MattWis/MADVLSI-Final/README.md

MADVLSI-Final
=============

An IC to limit current when hooked up to an external power FET
