MattWis/MADVLSI-Final/Report_WDR/Schematic_DAC.pdf

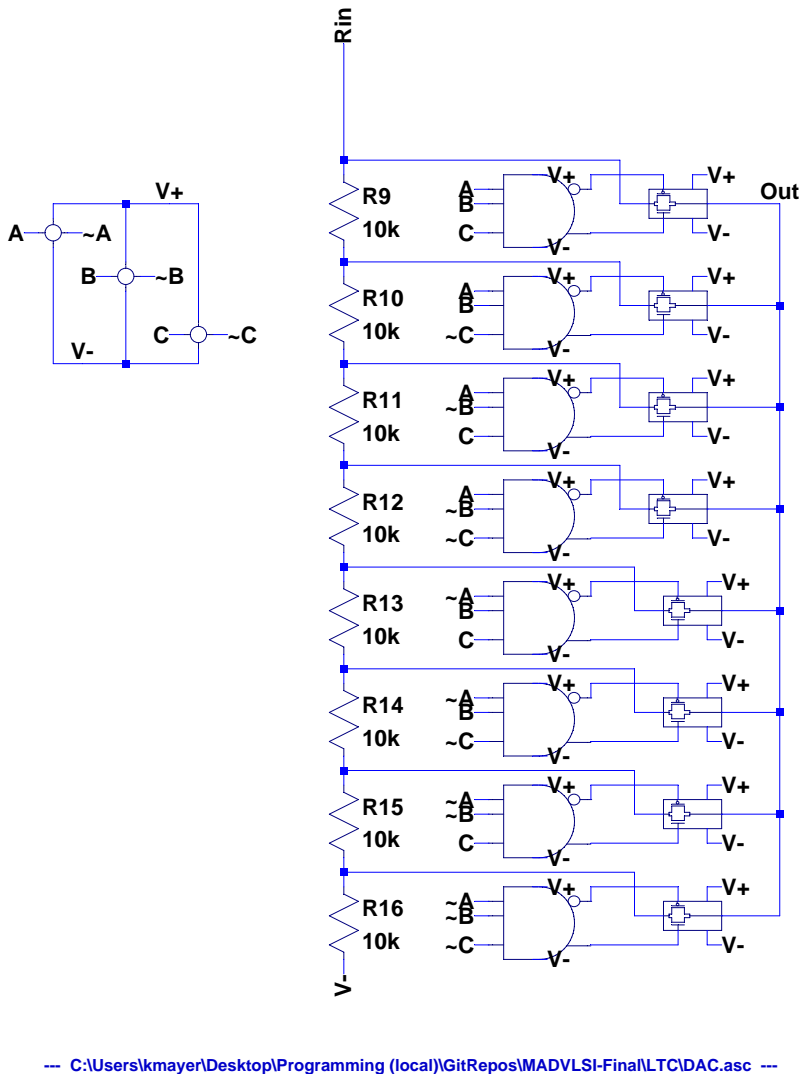
[picture p6: page 1]

--- C:\Users\kmayer\Desktop\Programming (local)\GitRepos\MADVLSI-Final\LTC\DAC.asc ---
