MattWis/MADVLSI-Final/Report_WDR/Schematic_Full_System.pdf

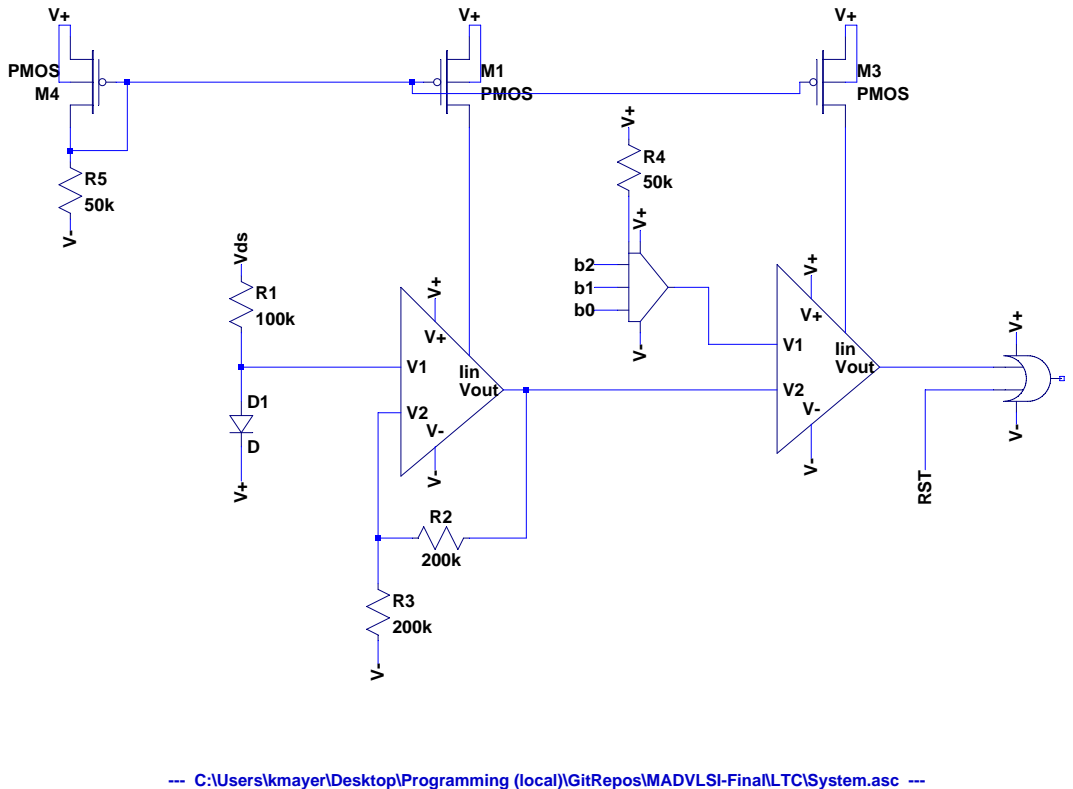
[picture p7: page 1]
Vout; Iin; M1 PMOS; M3 PMOS; PMOS; Vds; RST

--- C:\Users\kmayer\Desktop\Programming (local)\GitRepos\MADVLSI-Final\LTC\System.asc ---
