MattWis/MADVLSI-Final/Report_WDR/Schematic_w_breakpoints.pdf

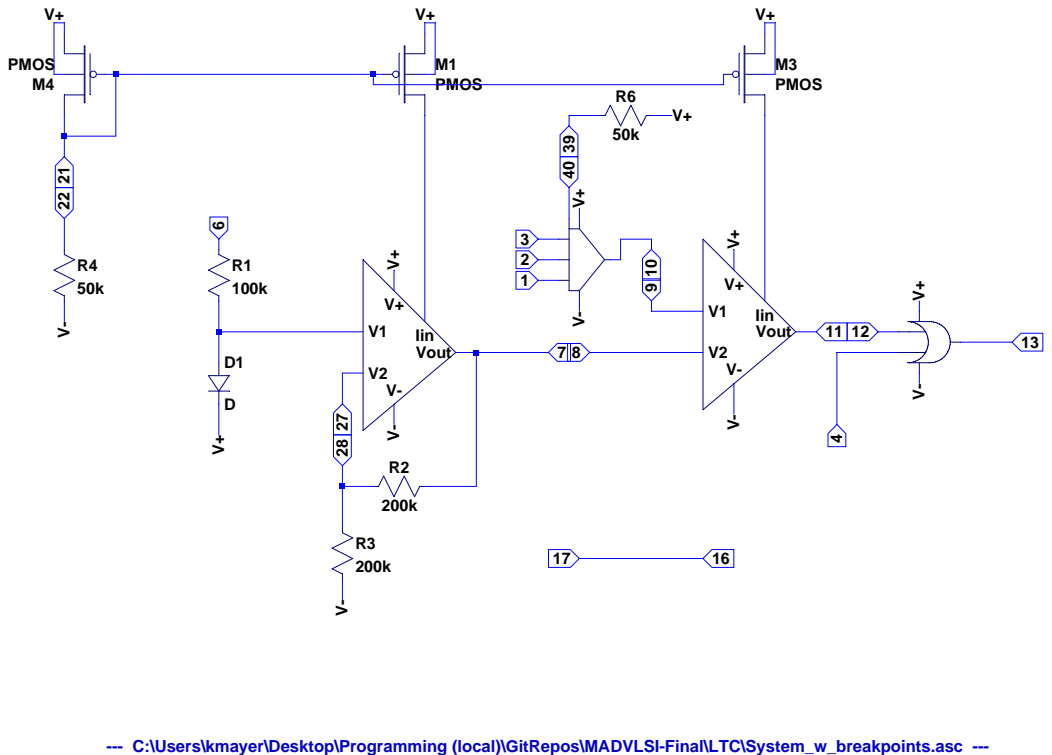
[picture p8: page 1]
Vout; Iin; M1 PMOS; PMOS

--- C:\Users\kmayer\Desktop\Programming (local)\GitRepos\MADVLSI-Final\LTC\System_w_breakpoints.asc ---
