MattWis/MADVLSI-Final/LTC/System_w_breakpoints.asc

D1: diode
M1: pmos4; l=1.8um w=36um
M3: pmos4; l=1.8um w=36um
M4: pmos4; l=1.8um w=36um
R1: res; 100k
R2: res; 200k
R3: res; 200k
R4: res; 50k
R6: res; 50k
X1: DAC
X2: Opamp
X3: Opamp
X5: 2-OR
Named nets: 1, 2, 3, V+, V-, 6, 4, 7, 8, 17, 16, 13, 39, 22, 12, 11, 27, 28, 40, 21, 10, 9
