MattWis/MADVLSI-Final/LTC/2-OR.asc

M1: nmos4; l=0.6um w=1.8um
M2: nmos4; l=0.6um w=1.8um
M3: pmos4; l=0.6um w=1.8um
M4: pmos4; l=0.6um w=1.8um
M5: pmos4; l=0.6um w=3.6um
M6: nmos4; l=0.6um w=1.8um
M7: nmos4; l=0.6um w=18um
M8: nmos4; l=0.6um w=180um
M9: pmos4; l=0.6um w=36um
M10: pmos4; l=0.6um w=360um
Named nets: V-, A, V+, B, Z
