MattWis/MADVLSI-Final/LTC/System.asc

D1: diode
D2: diode
I3: current; PULSE(0 10 1ms 10ms 1ms 0ms 11ms 2)
M1: pmos4; l=1.8um w=36um
M2: nmos; FDS2734
M3: pmos4; l=1.8um w=36um
M4: pmos4; l=1.8um w=36um
R1: res; 100k
R2: res; 200k
R3: res; 200k
R4: res; 50k
R5: res; 50k
V1: voltage; 5
V2: voltage; PULSE(5 0 1ms 100ns 100ns 11ms 20ms 1)
V3: voltage; 0
V4: voltage; 0
V5: voltage; 5
X1: DAC
X2: Opamp
X3: Opamp
X5: 2-OR
Named nets: b0, b1, b2, V+, V-, Vds, 0, RST
.lib engr3426.sub
.tran 30ms
