MattWis/MADVLSI-Final/LTC/DAC.asc

R9: res; 10k
R10: res; 10k
R11: res; 10k
R12: res; 10k
R13: res; 10k
R14: res; 10k
R15: res; 10k
R16: res; 10k
X9: Inverter
X10: Inverter
X11: Inverter
X12: PassGate
X13: PassGate
X14: PassGate
X15: PassGate
X16: PassGate
X17: PassGate
X18: PassGate
X19: PassGate
X20: 3-N-AND
X21: 3-N-AND
X22: 3-N-AND
X23: 3-N-AND
X24: 3-N-AND
X25: 3-N-AND
X26: 3-N-AND
X27: 3-N-AND
Named nets: V-, Rin, A, ~A, B, ~B, C, ~C, V+, Out
