MattWis/MADVLSI-Final/LTC/Bias.asc

M1: nmos4; l=1.8um w=36um
M2: nmos4; l=1.8um w=36um
M3: nmos4; l=1.8um w=36um
M4: nmos4; l=1.8um w=36um
M5: nmos4; l=1.8um w=36um
M6: nmos4; l=1.8um w=36um
M7: nmos4; l=1.8um w=1.8um
M8: pmos4; l=1.8um w=36um
M9: pmos4; l=1.8um w=36um
M10: pmos4; l=1.8um w=1.8um
M11: pmos4; l=1.8um w=36um
M12: pmos4; l=1.8um w=36um
M13: pmos4; l=1.8um w=36um
Named nets: V+, V-, Vcn, Vcp, Vbn, Vbp, Iin, Iip
1/20
1/20
.tran 1ms
