MattWis/MADVLSI-Final/LTC/FCDAmp.asc

M1: pmos4; l=1.8um w=36um
M2: pmos4; l=1.8um w=36um
M3: pmos4; l=1.8um w=36um
M4: pmos4; l=1.8um w=36um
M5: pmos4; l=1.8um w=36um
M6: pmos4; l=1.8um w=36um
M7: pmos4; l=1.8um w=36um
M8: nmos4; l=1.8um w=36um
M9: nmos4; l=1.8um w=36um
M10: nmos4; l=1.8um w=36um
M11: nmos4; l=1.8um w=36um
Named nets: V+, V-, Vout, V1, V2, Vbp, Vcp, Vcn, Vbn
