MattWis/MADVLSI-Final/LTC/Opamp.asc

X1: Bias
X2: FCDAmp
Named nets: V+, V1, V2, Iin, Vbn, Vcn, Vcp, Vbp, Vout, V-
