MattWis/MADVLSI-Final/LTC/3-N-AND.asc

M1: nmos4; l=0.6um w=1.8um
M2: nmos4; l=0.6um w=1.8um
M3: nmos4; l=0.6um w=1.8um
M4: pmos4; l=0.6um w=1.8um
M5: pmos4; l=0.6um w=1.8um
M6: pmos4; l=0.6um w=1.8um
M7: pmos4; l=0.6um w=1.8um
M8: nmos4; l=0.6um w=1.8um
Named nets: A, B, C, V+, V-, ~Z, Z
.lib engr3426.sub
