MattWis/MADVLSI-Final/LTC/PassGate.asc

M1: nmos4; l=0.6um w=1.8um
M2: pmos4; l=0.6um w=1.8um
Named nets: V-, V+, In, Out, A, ~A
