MattWis/MADVLSI-Final/(commit log)

2014-11-13 Schematics for 3 bit DAC with full pass-gates
2014-11-15 Pulled top resistor out of DAC, removed simulation sources
2014-11-18 Add external resistor to DAC, simulate with external FET
2014-11-20 Added OR gate, reset pin
2014-12-01 Use a resistor as a current source, mirror to op-amp bias
2014-12-04 High current output from OR gate
2014-12-16 Initial full-chip layout. Opamps properly connected, start of bias currents
2014-12-17 added all magic files for DAC. both the resistor portion and the rest of it have matching netlists. For some reason the full dac doesn't, but the comp.out says that everything matches up.
2014-12-17 Added 'fuse' between pads 34 and 36
2014-12-17 Add Current mirror pull-down resistor
2014-12-17 began the report and added a schematic of the breakpoints
